pridolfi/debugger/doc/debug.png

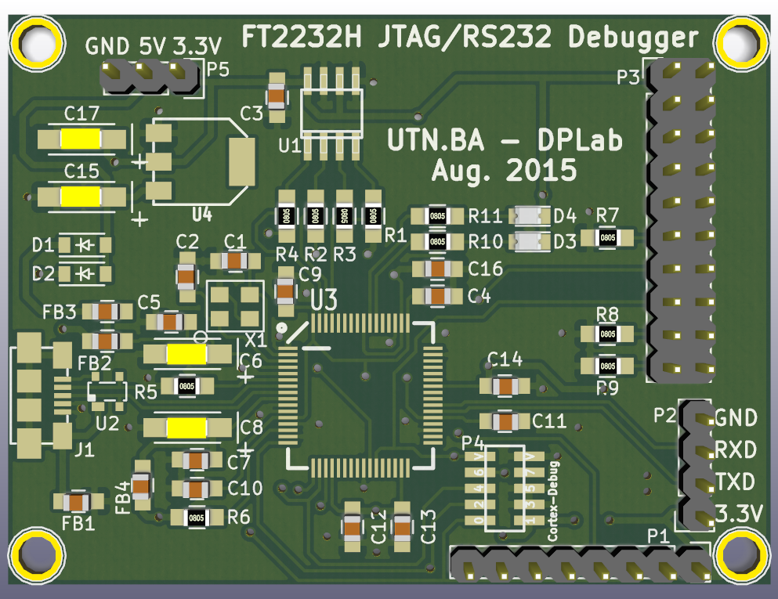
doc/debug.png
