pridolfi/debugger/README.md

# debugger
Simple JTAG debugger based on FT2232H.
