pridolfi/debugger/debug.kicad_pcb

## KiCad design debug.kicad_pcb (2015-08-28)

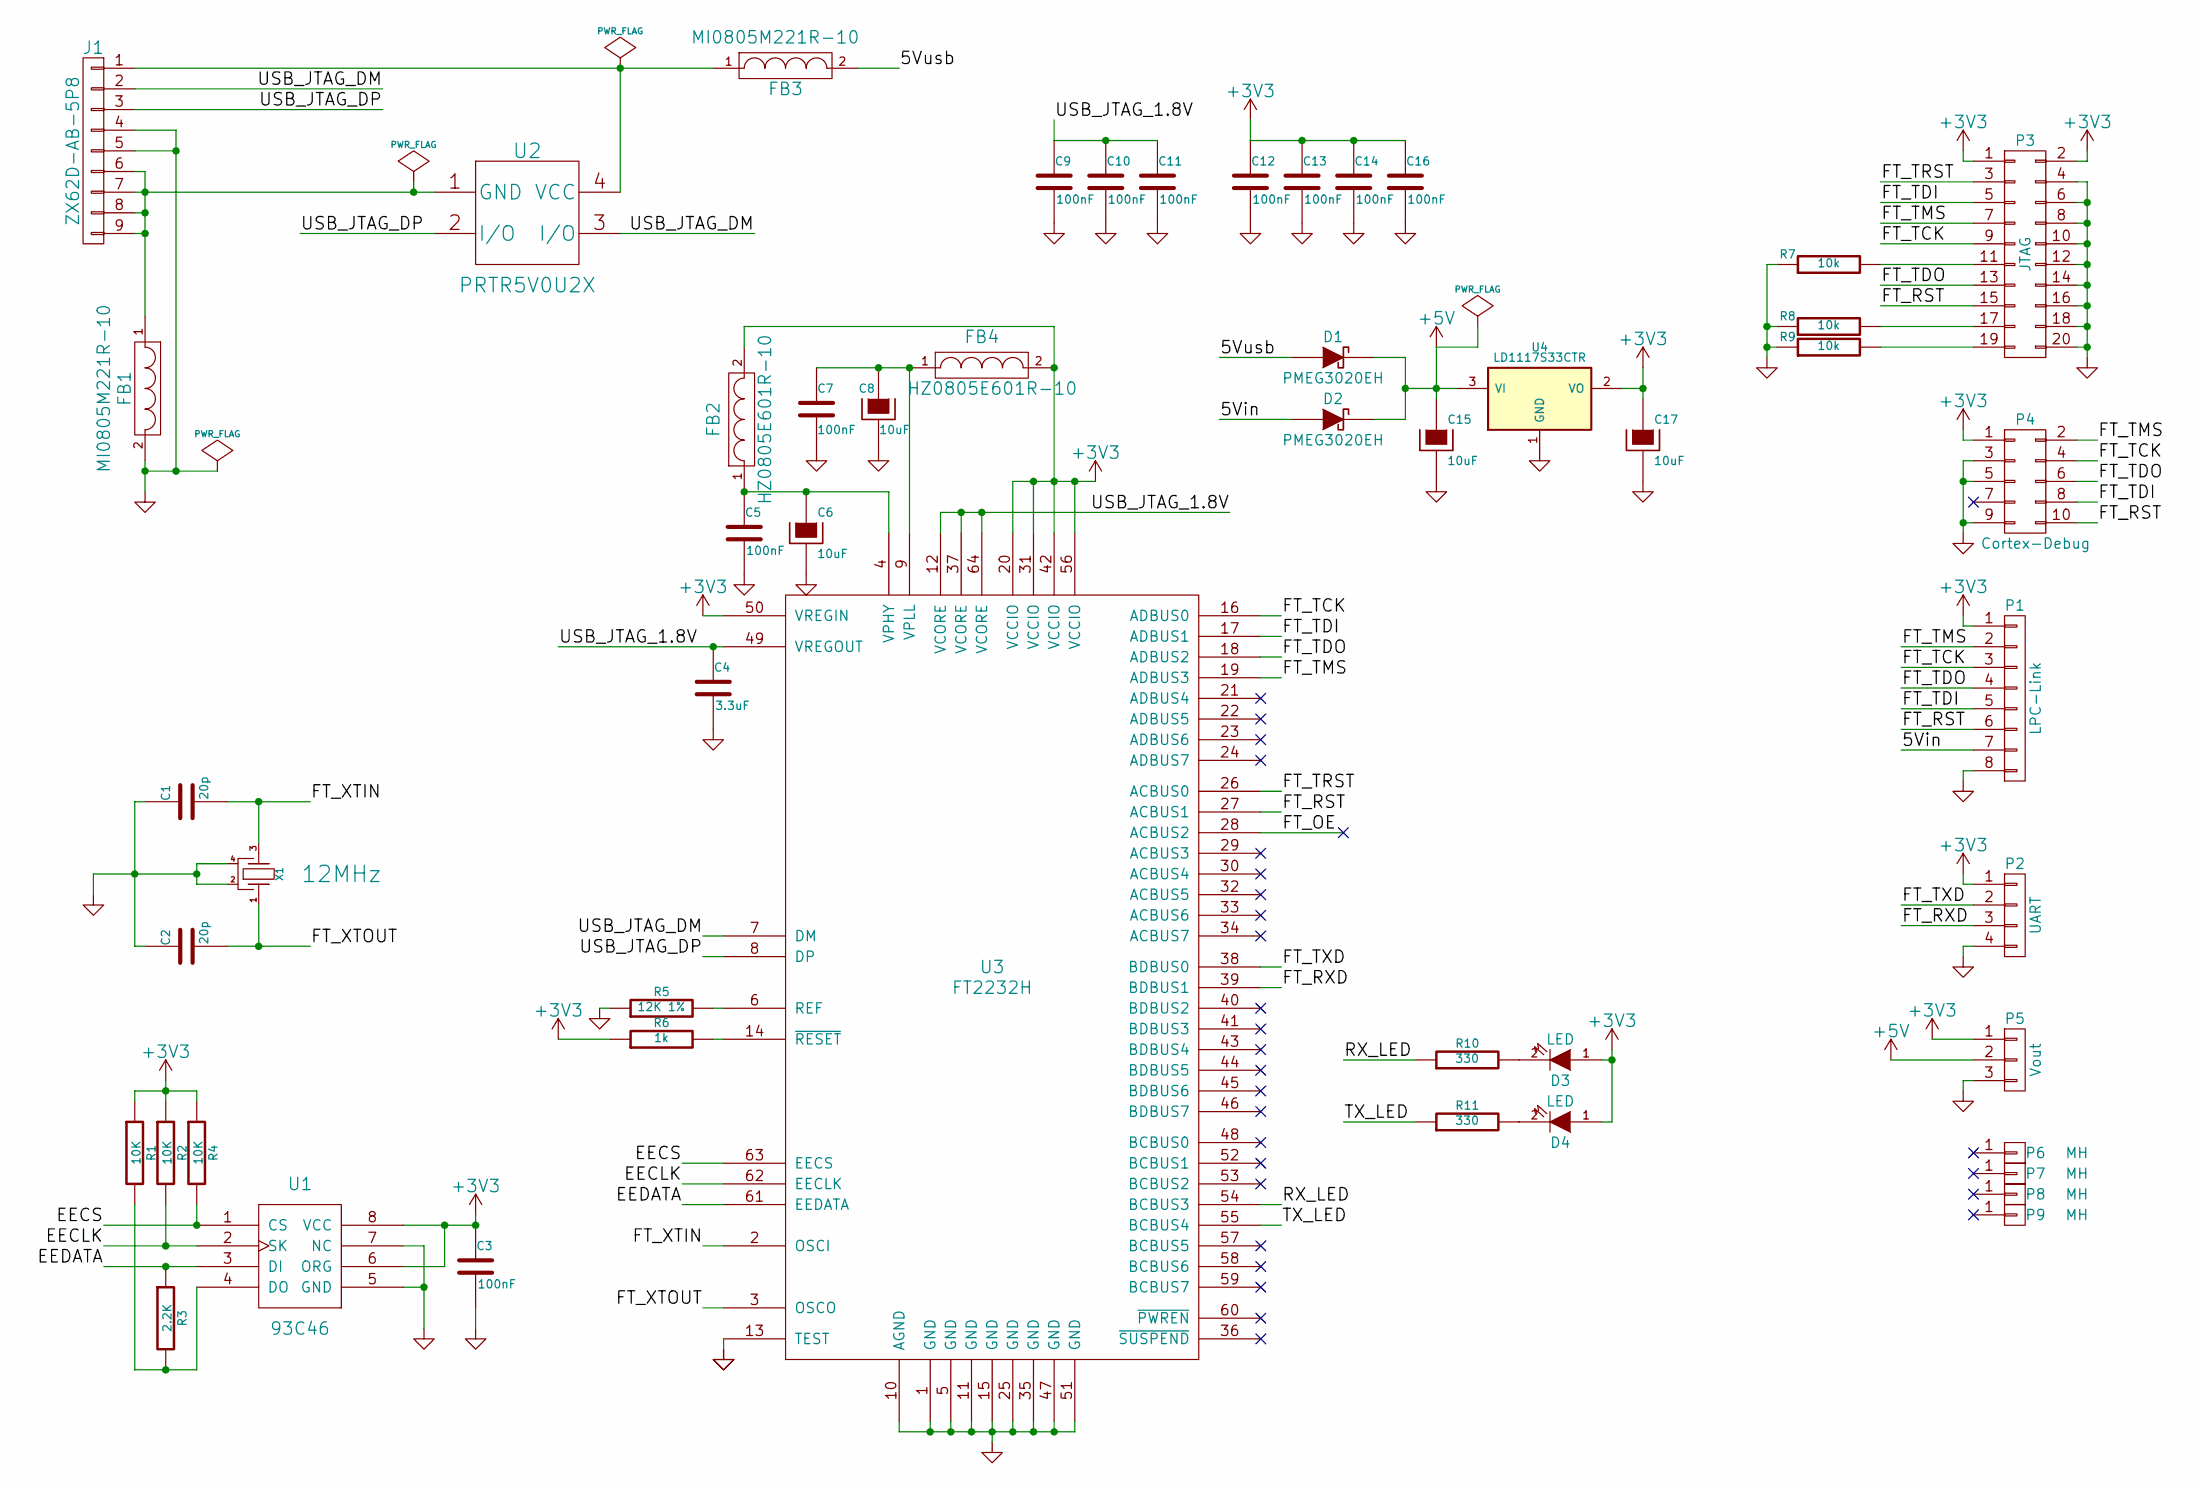
[picture p3: schematic debug.sch, Info II Stick]

Parts:
C1, C2: 20p; C_0805_HandSoldering; Digikey 399-8033-1-ND
C3, C5, C7, C9, C10, C11, C12, C13, C14, C16: 100nF; C_0805_HandSoldering; Digikey 399-1167-1-ND
C4: 3.3uF; C_0805_HandSoldering; Digikey 445-7582-1-ND
C6, C8, C15, C17: 10uF; TantalC_SizeA_EIA-3216_HandSoldering; Digikey 399-3525-1-ND
D1, D2: PMEG3020EH; SOD-123
D3, D4: LED; LED-0805
FB1, FB3: MI0805M221R-10; C_0805_HandSoldering; Digikey 240-2392-1-ND
FB2, FB4: HZ0805E601R-10; C_0805_HandSoldering; Digikey 240-2399-1-ND
J1: ZX62D-AB-5P8; USB_microAB_ZX62-AB&B-5PA-11; Digikey H11494CT-ND
P1: LPC-Link; Pin_Header_Straight_1x08
P2: UART; Pin_Header_Straight_1x04
P3: JTAG; Pin_Header_Straight_2x10
P4: Cortex-Debug; Pin_Array_5x2_1.27mm_SMD
P5: Vout; Pin_Header_Straight_1x03
P6, P7, P8, P9: MH; 1pin
R1, R2, R4: 10K; R_0805_HandSoldering; Digikey P10KACT-ND
R3: 2.2K; R_0805_HandSoldering; Digikey RMCF0805JT2K20CT-ND
R5: 12K 1%; R_0805_HandSoldering; Digikey 311-12.0KCRCT-ND
R6: 1k; R_0805_HandSoldering; Digikey RR12P15.0KDCT-ND
R7, R8, R9: 10k; R_0805_HandSoldering; Digikey 311-12.0KCRCT-ND
R10, R11: 330; R_0805_HandSoldering; Digikey 311-12.0KCRCT-ND
U1: 93C46; -SOIC8; Digikey AT93C46DN-SH-TCT-ND
U2: PRTR5V0U2X; SOT-143B; Digikey 568-4140-1-ND
U3: FT2232H; LQFP64-M05; Digikey 768-1024-1-ND
U4: LD1117S33CTR; SOT223_Opendous
X1: 12MHz; FA238V-XTAL; Digikey/Mouser 887-1831-1-ND

Connections:
+3V3: C3.1, C12.1, C13.1, C14.1, C16.1, C17.1, D3.1 (A), D4.1 (A), FB2.2, FB4.2, P1.1, P2.1, P3.1, P3.2, P4.1, P5.1, R1.1, R2.1, R4.1, R6.1, U1.6 (ORG), U1.8 (VCC), U3.20 (VCCIO), U3.31 (VCCIO), U3.42 (VCCIO), U3.50 (VREGIN), U3.56 (VCCIO), U4.2 (VO)
+5V: C15.1, D1.2 (K), D2.2 (K), P5.2, U4.3 (VI)
/5Vin: D2.1 (A), P1.7
/5Vusb: D1.1 (A), FB3.2
/EECLK: R2.2, U1.2 (SK), U3.62 (EECLK)
/EECS: R4.2, U1.1 (CS), U3.63 (EECS)
/EEDATA: R3.1, U1.3 (DI), U3.61 (EEDATA)
/FT_OE: U3.28 (ACBUS2)
/FT_RST: P1.6, P3.15, P4.10, U3.27 (ACBUS1)
/FT_RXD: P2.3, U3.39 (BDBUS1)
/FT_TCK: P1.3, P3.9, P4.4, U3.16 (ADBUS0)
/FT_TDI: P1.5, P3.5, P4.8, U3.17 (ADBUS1)
/FT_TDO: P1.4, P3.13, P4.6, U3.18 (ADBUS2)
/FT_TMS: P1.2, P3.7, P4.2, U3.19 (ADBUS3)
/FT_TRST: P3.3, U3.26 (ACBUS0)
/FT_TXD: P2.2, U3.38 (BDBUS0)
/FT_XTIN: C1.2, U3.2 (OSCI), X1.3 (B)
/FT_XTOUT: C2.2, U3.3 (OSCO), X1.1 (A)
/RX_LED: R10.1, U3.54 (BCBUS3)
/TX_LED: R11.1, U3.55 (BCBUS4)
/USB_JTAG_1.8V: C4.1, C9.1, C10.1, C11.1, U3.12 (VCORE), U3.37 (VCORE), U3.49 (VREGOUT), U3.64 (VCORE)
/USB_JTAG_DM: J1.2, U2.3 (I/O), U3.7 (DM)
/USB_JTAG_DP: J1.3, U2.2 (I/O), U3.8 (DP)
GND: C1.1, C2.1, C3.2, C4.2, C5.2, C6.2, C7.2, C8.2, C9.2, C10.2, C11.2, C12.2, C13.2, C14.2, C15.2, C16.2, C17.2, FB1.2, J1.4, J1.5, P1.8, P2.4, P3.4, P3.6, P3.8, P3.10, P3.12, P3.14, P3.16, P3.18, P3.20, P4.3, P4.5, P4.9, P5.3, R5.1, R7.1, R8.1, R9.1, U1.5 (GND), U1.7 (NC), U3.1 (GND), U3.5 (GND), U3.10 (AGND), U3.11 (GND), U3.13 (TEST), U3.15 (GND), U3.25 (GND), U3.35 (GND), U3.47 (GND), U3.51 (GND), U4.1 (GND), X1.2 (GND), X1.4 (GND)
unnamed: C5.1, C6.1, FB2.1, U3.4 (VPHY)
unnamed: C7.1, C8.1, FB4.1, U3.9 (VPLL)
unnamed: D3.2 (K), R10.2
unnamed: D4.2 (K), R11.2
unnamed: FB1.1, J1.6, J1.7, J1.8, J1.9, U2.1 (GND)
unnamed: FB3.1, J1.1, U2.4 (VCC)
unnamed: P3.11, R7.2
unnamed: P3.17, R8.2
unnamed: P3.19, R9.2
unnamed: R1.2, R3.2, U1.4 (DO)
unnamed: R5.2, U3.6 (REF)
unnamed: R6.2, U3.14 (~RESET)

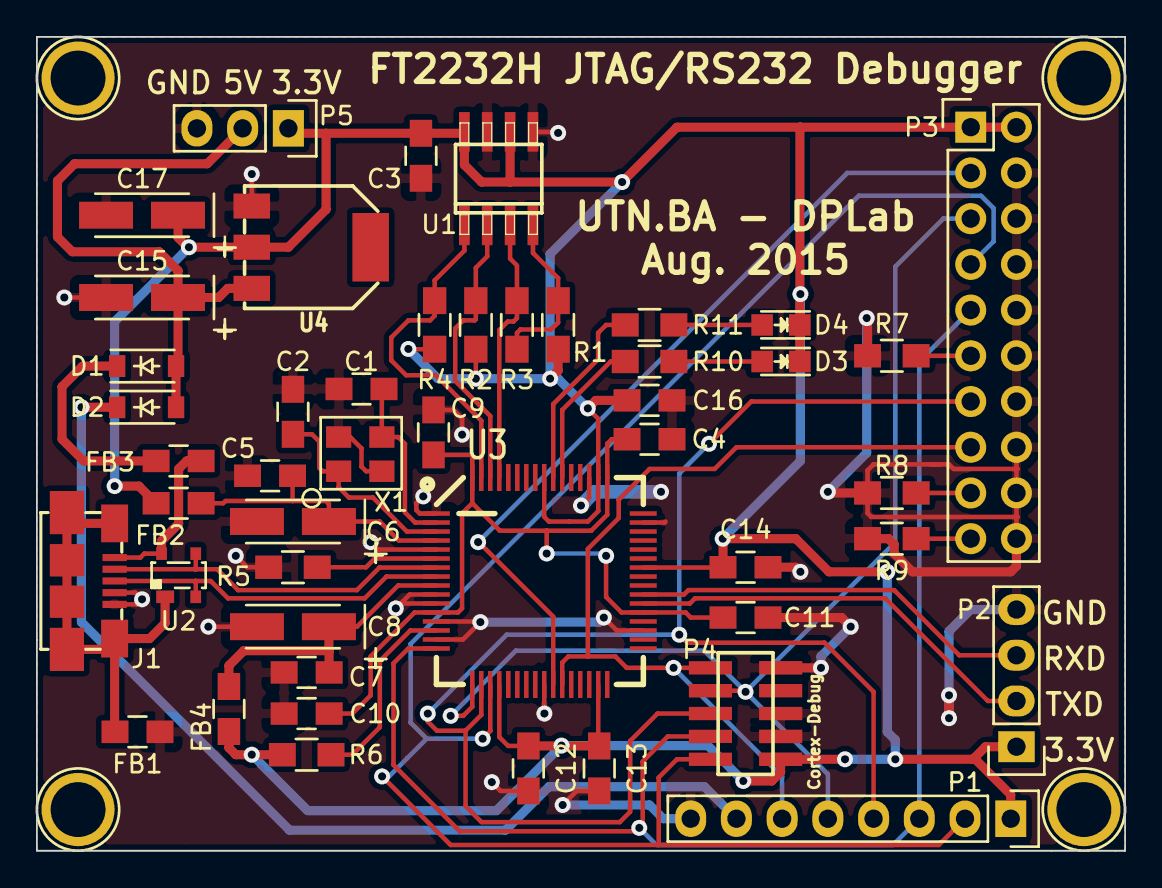
[picture p4: board debug.kicad_pcb from above]

Board: 2 copper layers, 60.5 x 45.2 mm, 51 parts (0 on the bottom side), 35 nets.
