pridolfi/debugger/(commit log)

2015-08-24 commit inicial, esquematico terminado
    [debug.sch]
2015-08-24 sch mejorado, erc ok, netlist generado
    [debug.sch]
2015-08-25 working on footprint association
    [bom.ods, debug.csv, debug.sch]
2015-08-26 footprint assoc done, working on placement
    [debug.kicad_pcb, debug.sch]
2015-08-26 place and route in progress...
    [debug.kicad_pcb]
2015-08-27 falta plano gnd
    [debug.kicad_pcb]
2015-08-28 pcb terminado, enviado a fabricacion
    [debug.kicad_pcb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]
2015-09-29 sch updated
    [debug.sch]
